nggugu/NGCL/production/bom.csv

Designator | Footprint | Quantity | Value | LCSC Part #
R1, R2, R3, R4, R5 | RES0603 | 5 | 10k
U1 | QFN50P410X410X100-24P | 1 | BQ24166
