nggugu/NGCL/models-3d/TLV9154IPWR.stp

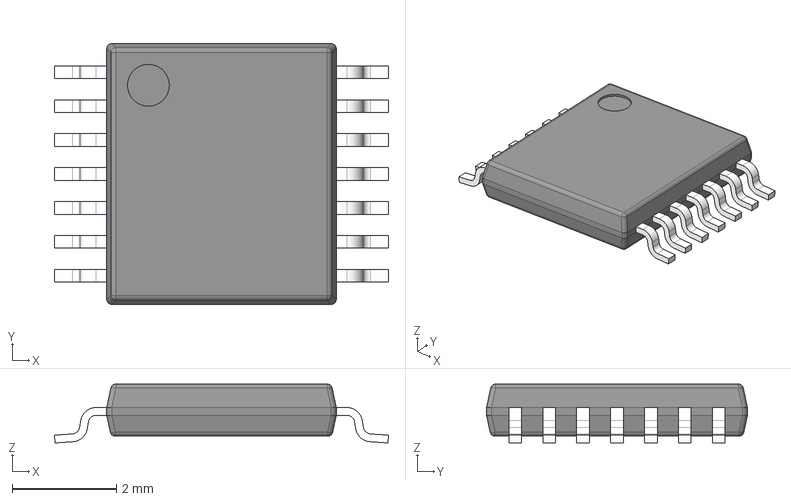
[picture p1: CAD file, 2025-02-15]
models-3d/TLV9154IPWR.stp
6.40 x 5.00 x 1.13 mm
BODY-TSSOP
LEAD-TSSOP x 14
PIN1
