nggugu/NGCL/models-3d/STM32L031x6.step

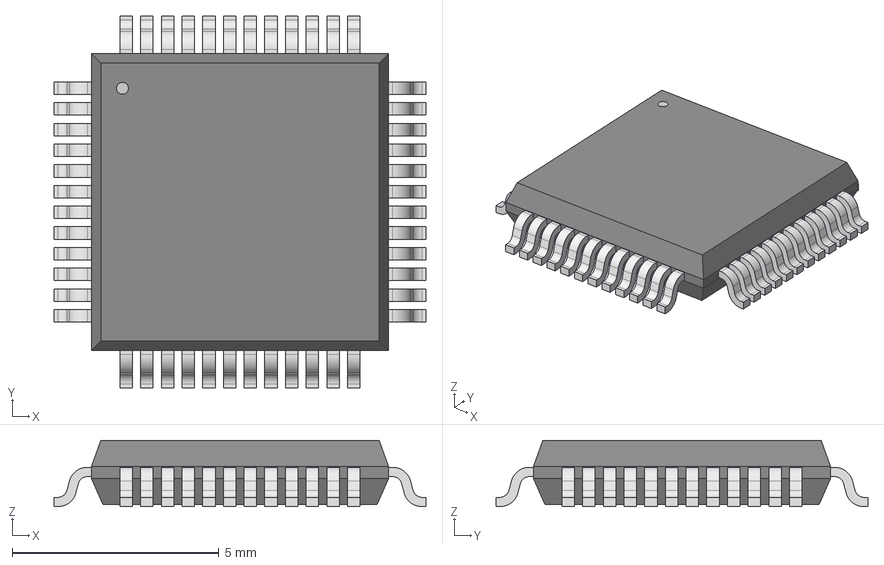
[picture p2: CAD file, 2025-02-11]
models-3d/STM32L031x6.step
8.99 x 8.99 x 1.60 mm
