nggugu/NGCL/models-3d/CAPC0603.step

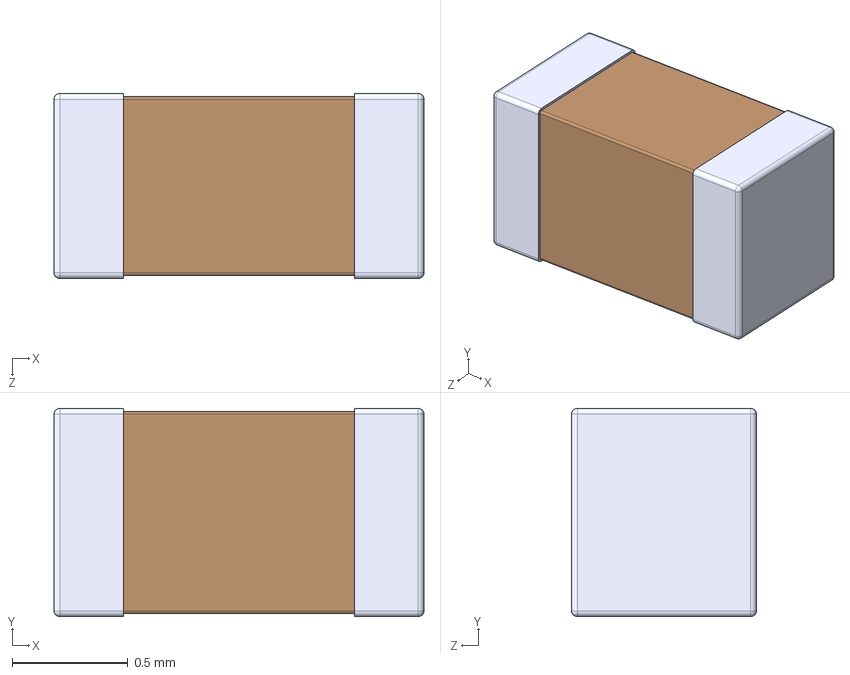
[picture p3: CAD file, 2025-02-11]
models-3d/CAPC0603.step
1.60 x 0.9 x 0.8 mm
