nggugu/NGCL/models-3d/CAPC0402.step

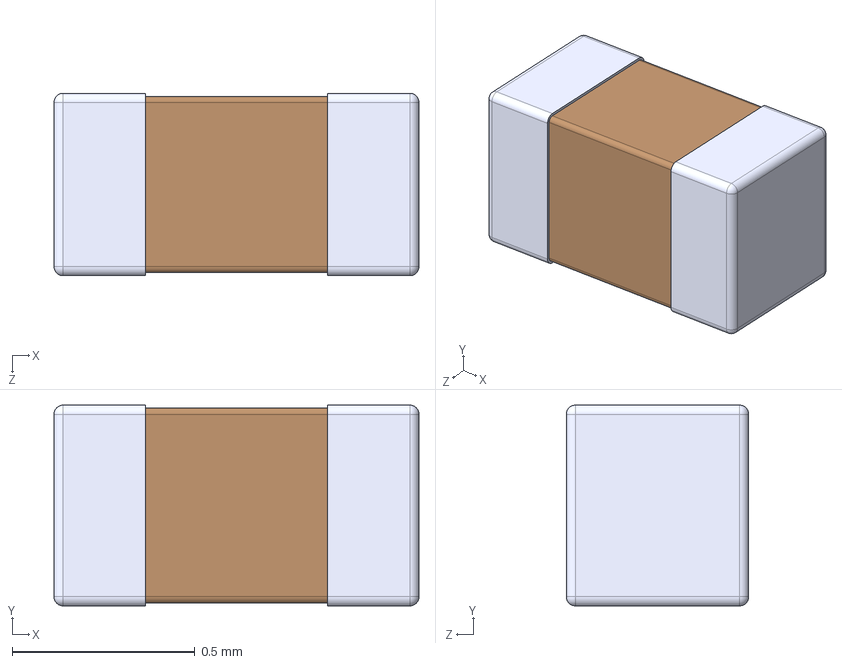
[picture p4: CAD file, 2025-02-11]
models-3d/CAPC0402.step
1.00 x 0.55 x 0.5 mm
