nggugu/NGCL/models-3d/RES0402.step

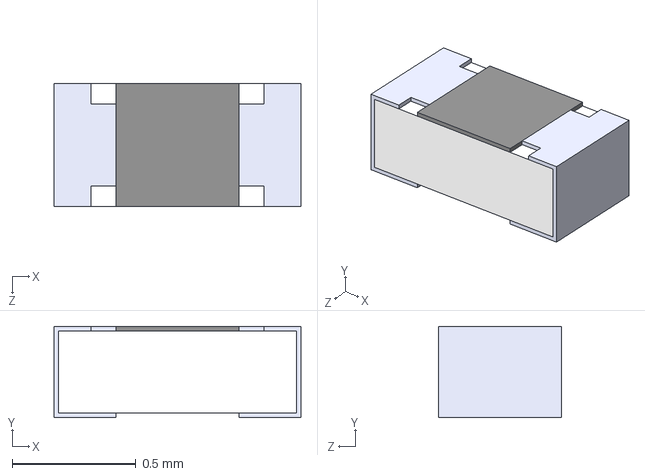
[picture p5: CAD file, 2025-01-14]
models-3d/RES0402.step
1 x 0.37 x 0.5 mm
