nggugu/NGCL/models-3d/BQ2416x_vqfn.stp

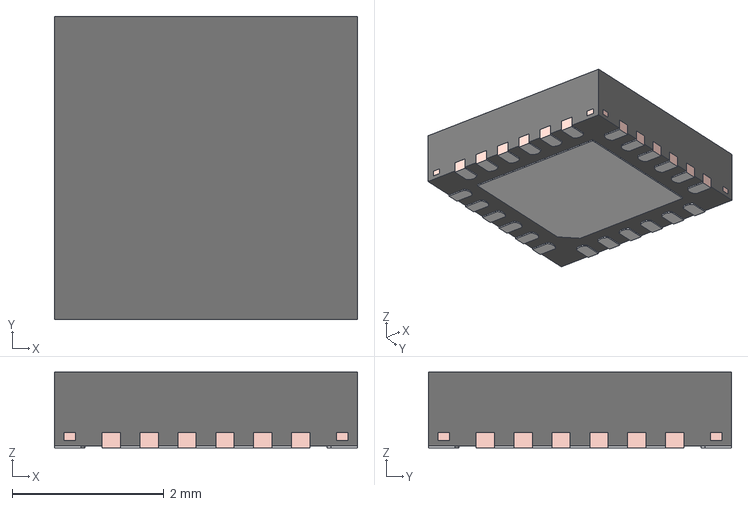
[picture p6: CAD file, 2025-01-14]
models-3d/BQ2416x_vqfn.stp
4.00 x 4.00 x 1.00 mm
FRAME
