nggugu/NGCL/models-3d/RES0805.step

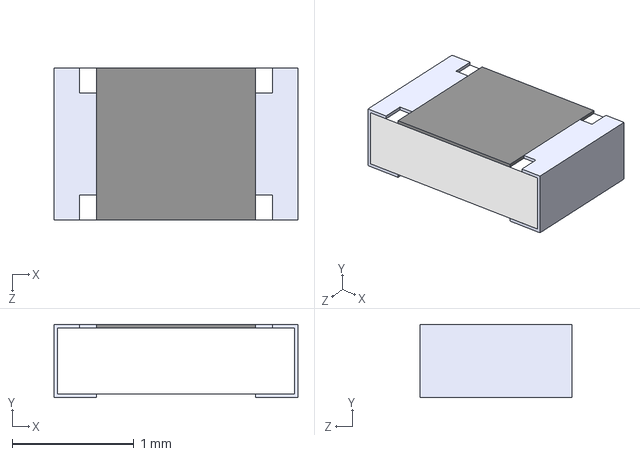
[picture p7: CAD file, 2025-01-14]
models-3d/RES0805.step
2.00 x 0.6 x 1.25 mm
