nggugu/NGCL/models-3d/RES0603.step

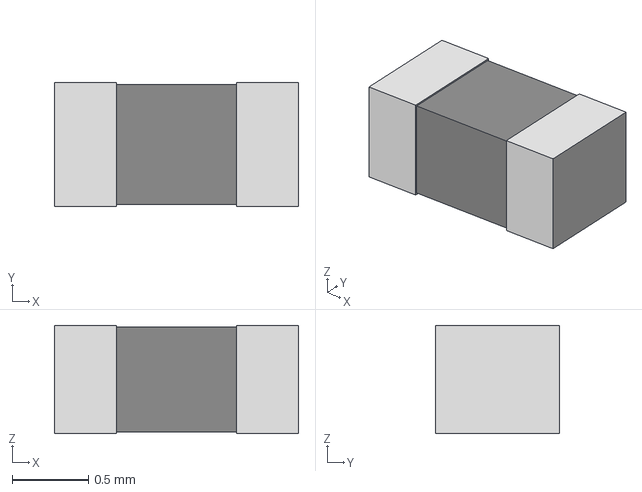
[picture p8: CAD file, 2025-01-14]
models-3d/RES0603.step
1.60 x 0.812 x 0.711 mm
