nggugu/NGCL/NGCL.kicad_pcb

## KiCad design NGCL.kicad_pcb (2025-01-14)

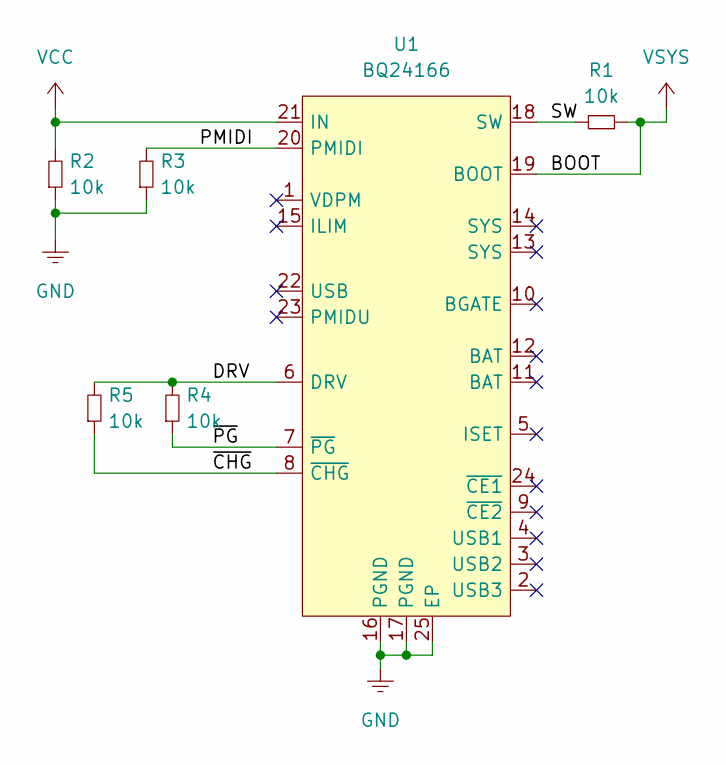
[picture p9: schematic NGCL.kicad_sch]

Parts:
R1, R2, R3, R4, R5: 10k; RES0603
U1: BQ24166; QFN50P410X410X100-24P

Connections:
/DRV: R4.2, R5.2, U1.6 (DRV)
/PMIDI: R3.2, U1.20 (PMIDI)
/SW: R1.2, U1.18 (SW)
/~CHG: R5.1, U1.8 (~CHG)
/~PG: R4.1, U1.7 (~PG)
GND: R2.1, R3.1, U1.16 (PGND), U1.17 (PGND), U1.25 (EP)
VCC: R2.2, U1.21 (IN)
VSYS: R1.1, U1.19 (BOOT)

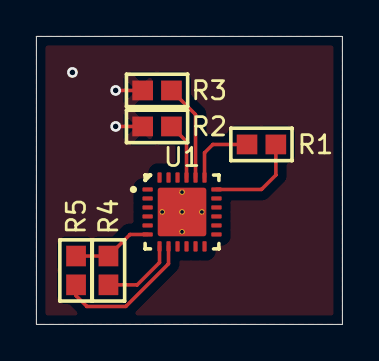
[picture p10: board NGCL.kicad_pcb from above]

Board: 2 copper layers, 17.0 x 16.0 mm, 6 parts (0 on the bottom side), 8 nets.
