nggugu/NGCL/(commit log)

2025-02-11 add some passives and audio connector
    [CAPC0402.step, CAPC0603.step, NGCL.kicad_sch, STM32L031x6.step]
2025-02-15 Add TLV9154IPWR
    [TLV9154IPWR.stp]
2025-02-15 add passives for analog filter
